alibeknakhimov/gravimetric-filling-line/firmware/README.md

# Firmware

This directory contains the firmware sources for the STM32F4 stepper /
fill controller. See "A note on the firmware sources" in the top-level
[`README.md`](../README.md).

## Target

| | |
|---|---|
| MCU | STM32F407VG (STM32F4 Discovery board as the carrier) |
| Toolchain | STM32CubeIDE / arm-none-eabi-gcc |
| HAL | STM32F4 HAL (Cube) |
| Linker scripts | `STM32F407VGTX_FLASH.ld`, `STM32F407VGTX_RAM.ld` |
| Configurator | STM32CubeMX (`FitoF4.ioc`) |
| Original project origin | MDK-ARM (Keil), re-generated against CubeIDE early in this project |

## Peripherals in use

| Peripheral | Config | Purpose |
|---|---|---|
| TIM7 | prescaler 167, period 99 → ~10 kHz, update IRQ, NVIC priority 0 | drum stepper only |
| TIM6 | prescaler 167, period 99 → ~10 kHz, update IRQ, NVIC priority 1 | nozzles, pump pulsing, bottle counting, USB CDC background TX |
| USART2 | PA2 / PA3, 115 200 8N1, IT RX per byte | Modbus RTU master to the QLST weighing bus |
| USB_OTG_FS | PA11 / PA12, CDC class | HMI link to the Raspberry Pi (replaces long UART) |
| GPIO | ~30 lines on ports A/B/C/D/E | step/dir/enable to Darlington array, end-switches, operator buttons |

## How to build

Open `FitoF4.ioc` in STM32CubeIDE (`File → Open Projects from File System`),
let it generate the project files, and build with the included GCC
toolchain. The build has no external dependencies beyond the STM32F4 HAL
and the ST USB CDC device middleware, both vendored under `Drivers/` and
`Middlewares/`.

The following CubeMX vendor packs were trimmed from this tree because
the project does not use them (CubeMX will re-create any of them on demand
if `.ioc` is regenerated):

- `MDK-ARM/`: the original Keil project, migrated to CubeIDE early on;
- `Documents/`: vendor PDFs;
- `Drivers/CMSIS/Lib/`: ~69 MB of pre-compiled CMSIS-DSP libraries (DSP
  is not used);
- `Drivers/CMSIS/DSP/`, `NN/`, `RTOS/`, `RTOS2/`, `docs/`: unused.

## What is not in this tree

- The hex last flashed on the machine is not stored here. This source is
  the line firmware with drum stepping moved onto TIM7. See the top-level
  README note.
- The legacy weighing-board firmware (STM32F1 + 4× HX711) and the legacy
  stepper-board firmware are the previous engineer's property and are
  **not** reproduced in this repository. The architectural "before"
  picture lives in [`../docs/legacy.md`](../docs/legacy.md) and
  [`../docs/architecture.md`](../docs/architecture.md).

## Where to start reading the code

| File | What it holds |
|---|---|
| `Core/Src/main.c` | Modbus master, fill algorithm, USB CDC HMI, operator tare, `IRQ_htim6` (nozzles and pumps), `IRQ_htim7` (drum) |
| `Core/Src/stm32f4xx_it.c` | IRQ vectors (`TIM6_DAC_IRQHandler`, `TIM7_IRQHandler`, `USART2_IRQHandler`) and their routing into `main.c` |
| `FitoF4.ioc` | the CubeMX configuration: authoritative for pin mapping, NVIC priorities, clock tree |
| `USB_DEVICE/` | ST's standard CDC device template, unmodified business logic (the sending path from main.c lives in `usb_mass_poll()`) |

Entry points inside `main.c` (approximate line ranges):

- **Modbus master:** `modbus_process()`, `modbus_send_request()`,
  `Modbus_CRC16()`, UART IT callbacks `HAL_UART_RxCpltCallback` and
  `HAL_UART_ErrorCallback`.
- **Operator tare & cycle framing:** `tare_all_scales()`,
  `set_tare_active_scales()`, `cancel_tare_all_scales()`.
- **Fill algorithm:** `update_fill_channel()`, `fill_channel_force_stop()`,
  `calculate_speeds()`, plus the fill-mode section at the bottom of the
  main loop (`rezhim == 3` branch).
- **Motion:** `IRQ_htim7()` steps the drum. `IRQ_htim6()` steps nozzles
  and pumps.
- **USB CDC HMI:** `usb_mass_request_send()`, `usb_mass_poll()`,
  `usb_append_int()`, plus the TIM6 call in the ISR body.
