alibeknakhimov/gravimetric-filling-line/docs/images/README.md

# Images

| File | Status | Shows |
|---|---|---|
| `01_machine_overview.jpg` | ✅ present | Full view of the 5-column filling machine with drum and nozzles. |
| `02_shield_top.jpg` | ✅ present | My RS-485↔UART shield, top view. |
| `03_shield_mounted.jpg` | ⬜ missing: welcome | The shield plugged into the original BRD2 connector on the stepper board. |
| `04_qlst_indicator.jpg` | ✅ present | A single QLST weighing indicator with display and buttons. |
| `05_harness_new.jpg` | ⬜ missing: welcome | New loom with ferrules, snap-off connectors, twisted pair for Modbus. |
| `06_field_closeup.jpg` | ✅ present | Close-up of the nozzle + load cell + bottle on the drum carrier. |

If you add 03 or 05 later, drop them in with the exact filenames above and
the README links will resolve automatically.

Guidelines before adding an image:

- No customer / plant / product name visible. Blur or crop logos, signs, labels.
- No faces of operators or colleagues.
- Prefer plain backgrounds for board photos (desk, A4 paper).
- Keep files under ~1 MB each; use JPG around 1600 px long side at ~85 % quality.
