alibeknakhimov/gravimetric-filling-line/FitoF4/FitoF4.ioc

Mcu.UserName=STM32F407VGTx
PA10.Signal=GPIO_Output
PA11.Signal=USB_OTG_FS_DM
PA12.Signal=USB_OTG_FS_DP
PA13.Signal=SYS_JTMS-SWDIO
PA14.Signal=SYS_JTCK-SWCLK
PA15.Signal=GPIO_Output
PA2.Signal=USART2_TX
PA3.Signal=USART2_RX
PA4.Signal=GPIO_Input
PA5.Signal=GPXTI5
PA7.Signal=GPIO_Output
PA8.Signal=GPIO_Output
PB0.Signal=GPIO_Output
PB1.Signal=GPIO_Input
PB10.Signal=GPIO_Output
PB13.Signal=GPIO_Output
PB14.Signal=GPIO_Output
PB15.Signal=GPIO_Output
PB4.Signal=GPIO_Output
PB6.Signal=GPIO_Output
PB8.Signal=GPIO_Output
PC1.Signal=GPIO_Input
PC10.Signal=GPIO_Output
PC11.Signal=GPIO_Output
PC12.Signal=GPIO_Output
PC13-ANTI_TAMP.Signal=GPIO_Input
PC14-OSC32_IN.Signal=GPIO_Input
PC15-OSC32_OUT.Signal=GPIO_Input
PC2.Signal=GPIO_Input
PC3.Signal=GPIO_Input
PC4.Signal=GPIO_Output
PC5.Signal=GPIO_Input
PC6.Signal=GPIO_Output
PC7.Signal=GPIO_Output
PC8.Signal=GPIO_Output
PC9.Signal=GPIO_Output
PD0.Signal=GPIO_Output
PD1.Signal=GPIO_Output
PD11.Signal=GPIO_Output
PD12.Signal=GPIO_Output
PD13.Signal=GPIO_Output
PD14.Signal=GPIO_Output
PD3.Signal=GPIO_Output
PD5.Signal=GPIO_Output
PD7.Signal=GPIO_Output
PD8.Signal=GPIO_Output
PE0.Signal=GPIO_Output
PE1.Signal=GPIO_Input
PE14.Signal=GPIO_Output
PE2.Signal=GPIO_Output
PE3.Signal=GPIO_Input
PE4.Signal=GPIO_Input
PE5.Signal=GPIO_Input
PE6.Signal=GPIO_Input
PE7.Signal=GPIO_Input
PH0-OSC_IN.Signal=RCC_OSC_IN
PH1-OSC_OUT.Signal=RCC_OSC_OUT
